mschnur/inexfensive/MegaDisplay/FencingTypes.h

#ifndef __INCLUDE_FENCING_TYPES_H__
#define __INCLUDE_FENCING_TYPES_H__

typedef enum FencerSide
{
  FENCER_A = 0,
  FENCER_B = 1
} FencerSide;

typedef enum WeaponType
{
  EPEE,
  FOIL,
  SABER
} WeaponType;

#endif // #ifndef __INCLUDE_FENCING_TYPES_H__
