mschnur/inexfensive/(commit log)

2015-12-14 Initial mega display integration. Has issues with sync between Mega and Uno on weapon change
    [ArduinoWeaponChangeInterface.c, DetectionInterface.h, DisplayInterface.h, Fencer.h, FencingBox.ino, FencingTypes.h, FoilMode.cpp, IRreceiver.h]
2015-12-16 Create arduino-programming-guide.md (unfinished)
2016-02-05 Move responsibility to control LED arrays and buzzer back to Uno
    [DisplayInterface.h, FencingBox.ino, MegaDisplay.ino]
2016-02-05 Update Uno display handling to use shift register controlled via SPI
2016-02-05 Fix pin constants to reflect new wiring scheme
    [ArduinoDisplayInterface.cpp, ArduinoWeaponChangeInterface.c, IRreceiver.h, MegaDisplay.ino, ScoreDisplay.h, TimerDisplay.h, WeaponModeDisplay.h]
2016-02-17 Use interrupt-driven timing for displaying touch, and use SPI to write to shift register
2016-02-17 Ensure that self contact lights are turned off if mode is switched to epee when self contact lights are on
2016-02-17 Make self contact status persist through reset that occurs after a touch is displayed
    [Fencer.h]
2016-02-17 Count the number of weapon changes interrupts that occur rather than simply setting a boolean to true, in case multiple occur before we can react
2016-02-17 Add support for new weapon mode change handling, also added code to change ADC prescaler to 32 for faster analogReads
2016-02-17 Use optimized detection interface, also optimizes how many times the current time is found
2016-02-17 Re-simplify uno interrupt handling, and only allow one weapon mode change per second
2016-02-29 Update pin mapping
2016-02-29 Update pin mapping and change weapon change handling to try and protect against unintended weapon mode changes
2016-02-29 Stop timer when scores are changed
2016-02-29 Don't allow reset time to be decreased below 1 minute
    [TimerDisplay.cpp]
2016-02-29 Make buzzer go off when time runs out
    [ArduinoDisplayInterface.cpp, DisplayInterface.h, FencingBox.ino]
